jdolecek/humidifier-scale/docs/build-gallery.md

# Humidifier scale build gallery

[Project README](../README.md) · [Wiring diagram](two-channel-wiring.svg) · [ESPHome setup](../esphome/README.md)

The build uses two load-cell rails, one for each side of the humidifier. Each rail has two 20 kg load cells connected in parallel to one HX711. A Wemos D1 mini V4.0.0 reads the two HX711 channels separately and sends the readings to Home Assistant through ESPHome.

## Bench assembly

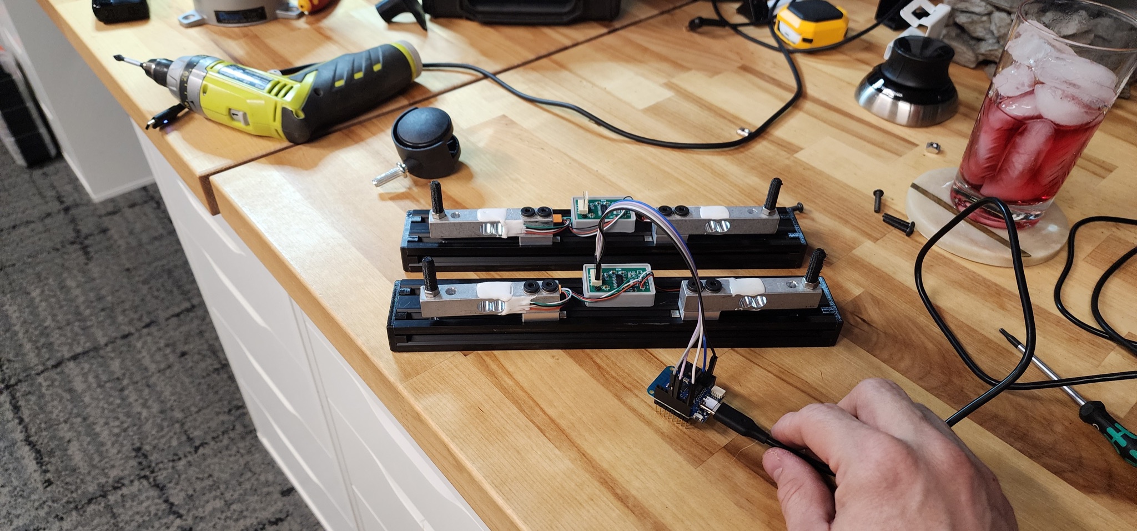
[picture p3: docs/photos/bench-assembly-overview.jpg]
Both load-cell rails on the workbench, connected to the D1 mini


*The two assembled rails before installation. Each has a pair of load cells and its own HX711 board; the jumper leads connect both channels to the D1 mini.*

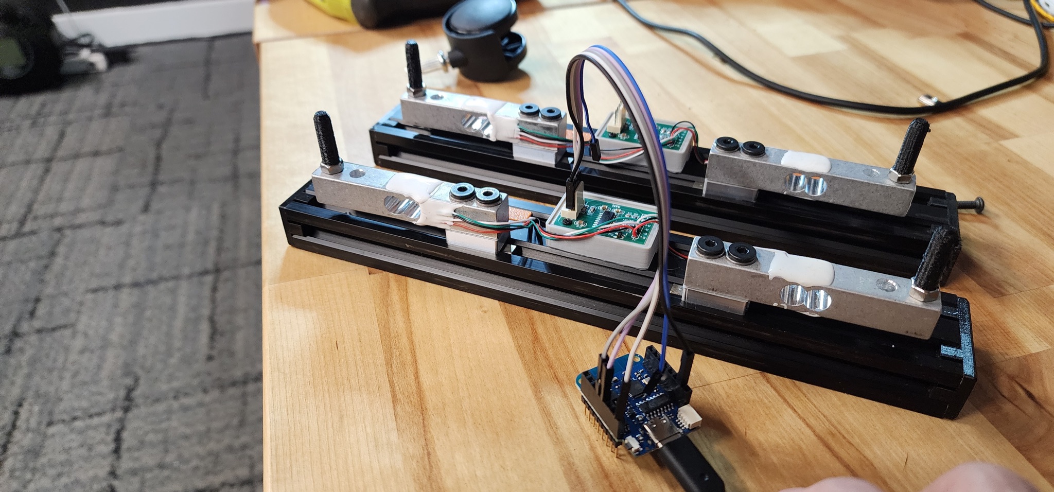
[picture p4: docs/photos/bench-load-cells-and-hx711.jpg]
Close view of the load cells, mounting spacers, HX711 holders, and controller


*Close-up of the rail hardware, white mounting spacers and HX711 holders, bridge wiring, and USB-powered controller.*

## Installing the rails

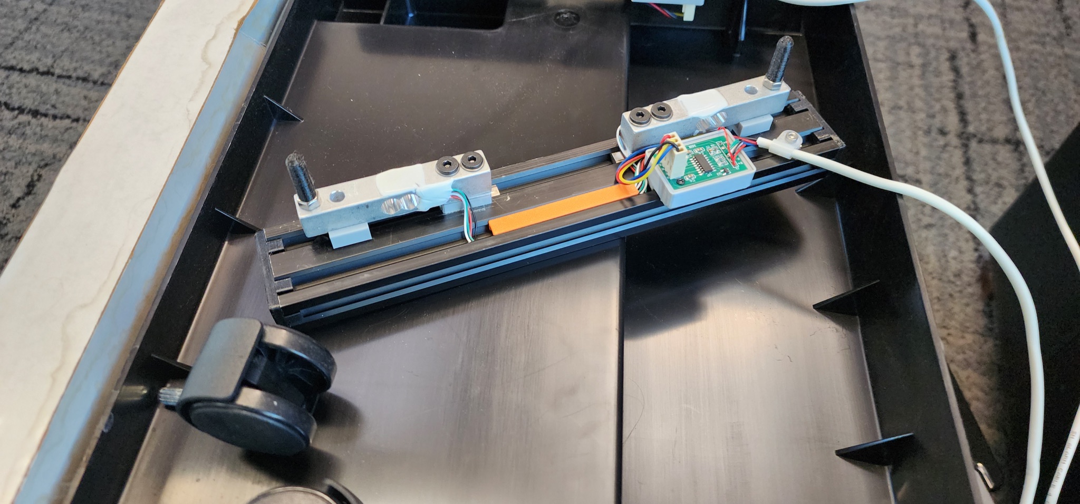
[picture p5: docs/photos/single-rail-installation.jpg]
One load-cell rail positioned inside the overturned humidifier base


*One rail positioned in the overturned base. The original caster nearby shows the mounting arrangement before reassembly.*

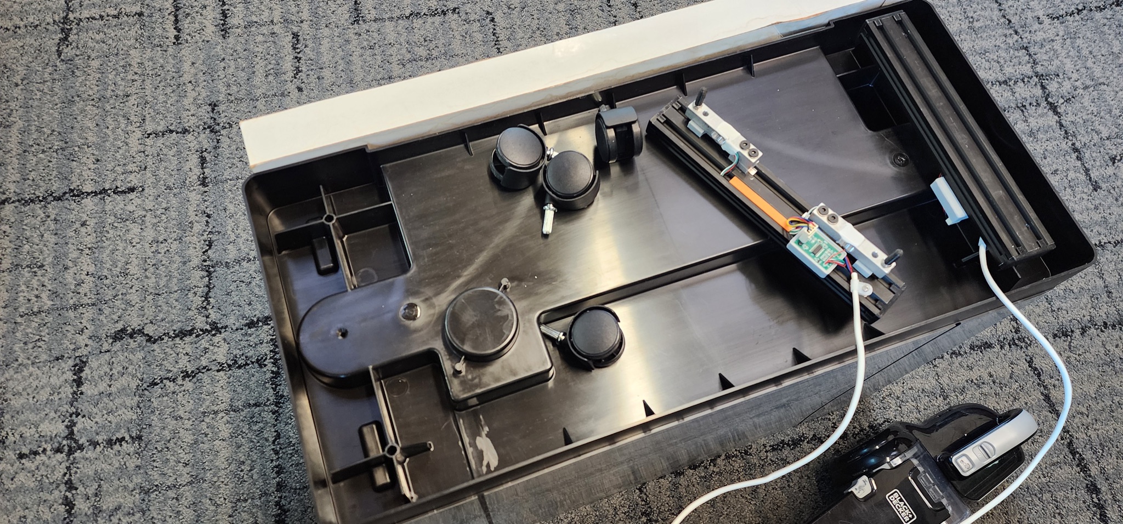
[picture p6: docs/photos/base-installation-in-progress.jpg]
Wider view of the humidifier base during rail installation


*Installation in progress, with the original casters removed and one rail in place.*

## Installed supports and wiring

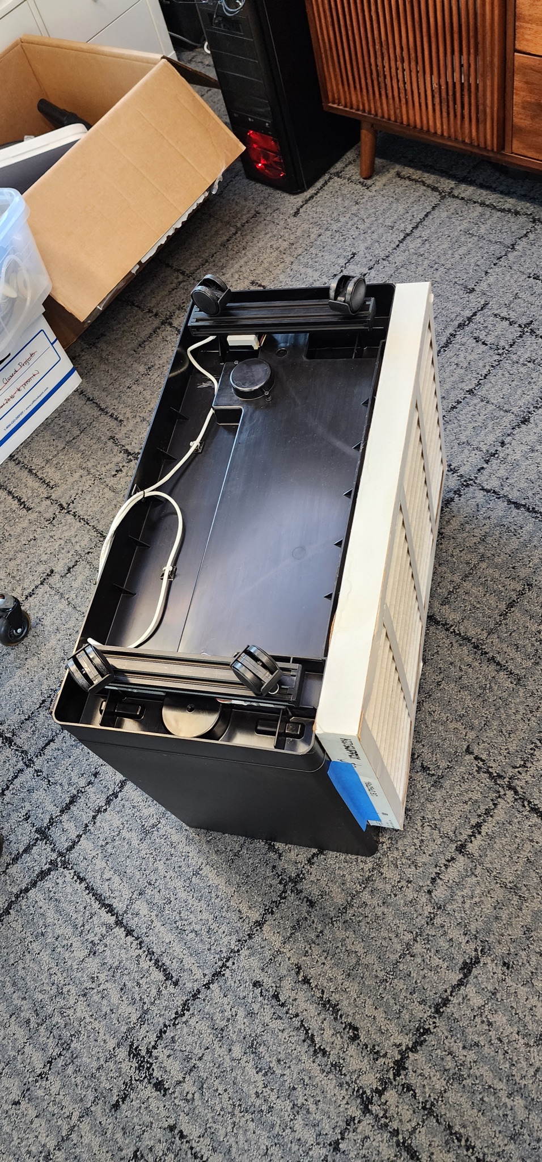
[picture p7: docs/photos/installed-rails-and-casters.jpg]
Portrait view of both installed rails and their casters on the overturned humidifier


*Both rails installed with the casters reattached. The white cables run along the underside of the base.*

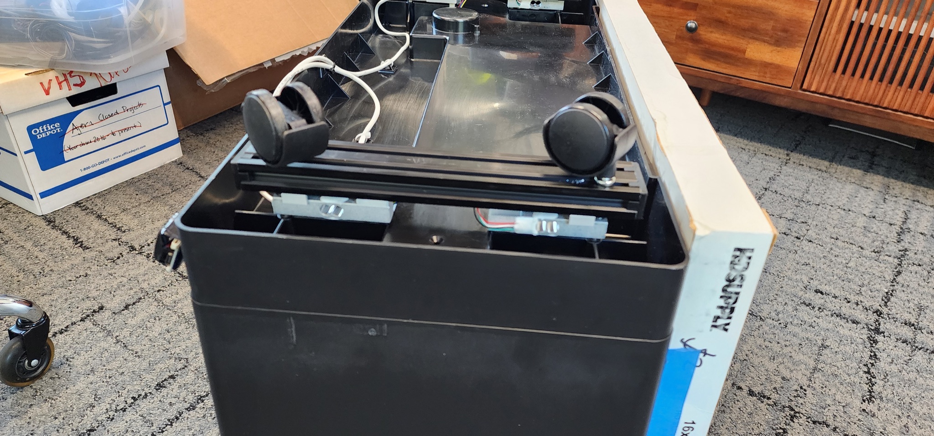
[picture p8: docs/photos/caster-and-load-cell-detail.jpg]
Side view showing the casters above the rail and load cells below it


*Side view of the caster, rail, and load-cell arrangement. The humidifier is upside down in these installation photos.*

Completed underside with both rails, four casters, and routed cables

*The completed underside: two instrumented rails, four casters, and cables secured along the base.*

For the electrical connections, use the [labeled wiring diagram](two-channel-wiring.svg). The photos document the physical build; wire colors alone do not identify a load cell's electrical functions.

## Home Assistant dashboard

Home Assistant tank-water dashboard showing overall level, separate left and right estimates, and reservoir status

*The tank-water card shows the combined estimate and fill percentage, separate left/right gallons and level bars, and reservoir status. This example shows 4.3 gallons total (86% of the 5-gallon target), with 2.13 gallons on the left and 2.17 gallons on the right. These are example readings from the screenshot, not calibration targets.*

---

Photos supplied by the project owner. Documentation copies are resized for the web, stored upright, and omit the original camera/location metadata. The source photos are unchanged.
