jdolecek/humidifier-scale/docs/two-channel-wiring.png

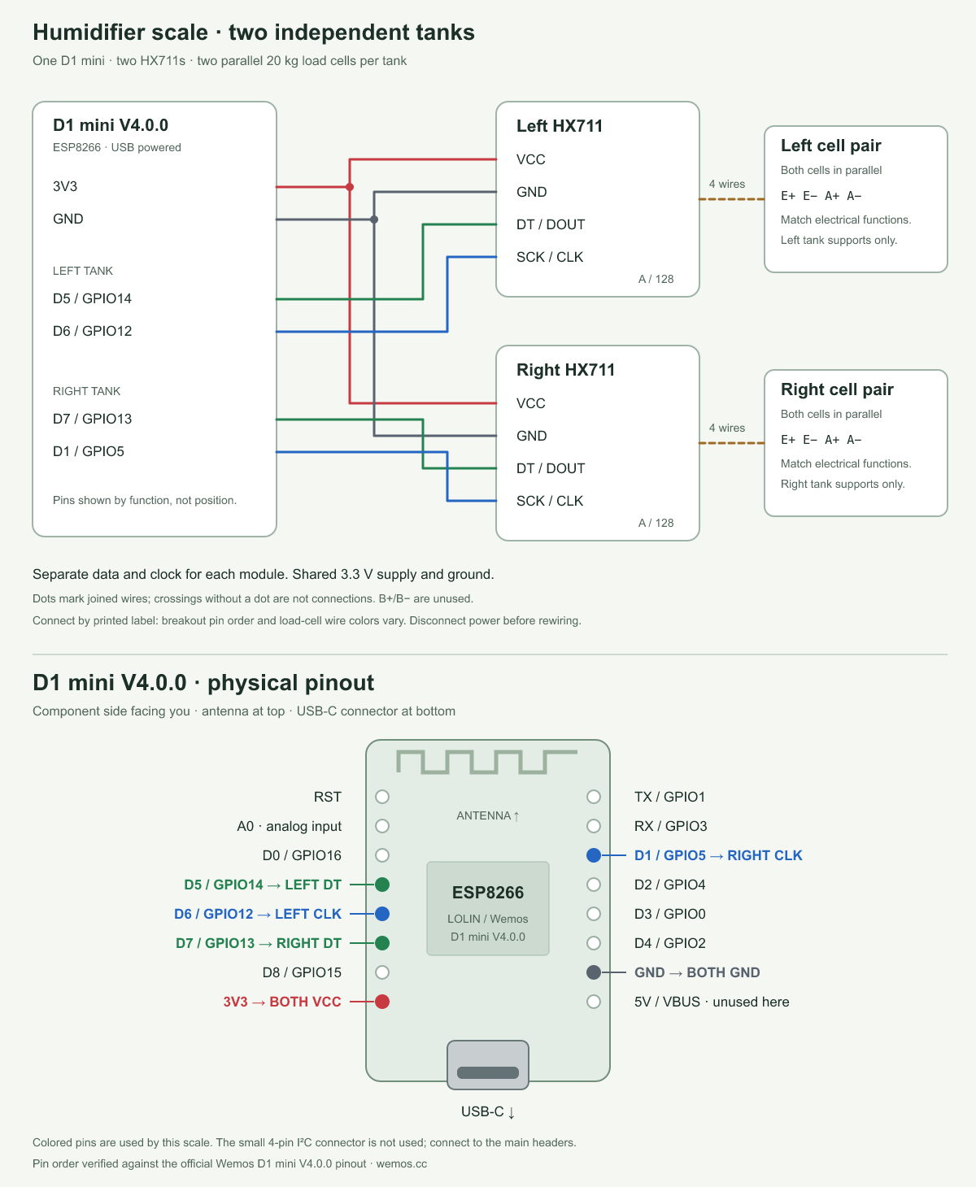
docs/two-channel-wiring.png
