jdolecek/humidifier-scale/(commit log)

2026-10-24 Add two-tank wiring diagram and ESPHome configuration
2026-10-24 Add D1 mini V4.0.0 physical pinout to wiring diagram
2026-10-31 Remove unrelated temperature probe from build gallery
